AmericanRedCross/mapping-mozzie/docs/partslist.md

# Parts List
These are the purchased items that become part of the aircraft.  

| type | name | source | qty | US$ (ea) | gms (ea) |
|--|--|--|--:|--:|--:|
| [airframe](parts/airframe.md) | X-uav Mini Talon (non-PNP) | [Banggood](https://www.banggood.com/X-uav-Mini-Talon-EPO-1300mm-Wingspan-V-tail-FPV-Plane-Aircraft-Kit-p-983331.html) | 1 | 104 | 562 |
| [servos](parts/servos.md) | Corona DS-929MG Digital Servo 2.2kg / 0.11sec / 12.5g | [HobbyKing](https://hobbyking.com/en_us/corona-digital-servo-2-2kg-0-11sec-12-5g.html) | 4 | 7 | 13 |
| [airspeed sensor](parts/airspeed.md) | Holybro digital air speed sensor | [amazon](https://www.amazon.com/HolyBro-Air-Speed-Sensor/dp/B07FN6615W) | 1 | 67 | - |
| [flight controller (bundle)](parts/flightcontroller.md) | Pixhawk 4 and GPS and PM02 Bundle. SKU20068 | [Holybro](https://shop.holybro.com/pixhawk-4_p1089.html) | 1 | 196 | - |
| [computer (on-board companion)](parts/computer.md) | Raspberry Pi 4 Model B 2GB RAM | [Adafruit](https://www.adafruit.com/product/4292) | 1 | 35 | 45 |
| [computer micro SD card](parts/sdcard.md) | Samsung PRO Endurance 128GB 100MB/s (U1) MicroSDXC Memory Card (MB-MJ128GA/AM) | [Amazon](https://www.amazon.com/Samsung-Endurance-32GB-Micro-Adapter/dp/B07B984HJ5) | 1 | 20 | 1 |
| [USB connectors](parts/usb.md) |  |  |  |  |  |
| [camera](parts/camera.md) | Raspberry Pi High Quality HQ Camera - 12MP | [Adafruit](https://www.adafruit.com/product/4561) | 1 | 50 | - |
| [camera lens](parts/camera.md) | 6mm 3MP Wide Angle Lens for Raspberry Pi HQ Camera - 3MP | [Adafruit](https://www.adafruit.com/product/4563) | 1 | 25 | 53 |
| [camera mount wood](parts/camerawood.md) | Used to build camera mount. .11" or 3mm thick. See [link](parts/camerawood.md) for alternatives. | [Michaels](https://www.michaels.com/revell-birch-plywood-sheet-3mmx6inx12in/10307259.html) | 1 | 2 | - |
| [camera mount dampers](parts/cameradampers.md) | Used to isolate vibrations | [Amazon](https://www.amazon.com/gp/product/B07WGPVZM6/) | 1 | 8 | 12 |
| [receiver](parts/receiver.md) | FrSKy R-XSR | [getFPV](https://www.getfpv.com/frsky-r-xsr-2-4ghz-16ch-accst-micro-receiver-w-s-bus-cppm.html) | 1 | 21 | 2 |
| [radio modem](parts/radio.md) | RFD900x-US Telemetry Bundle (FCC approved) 2 modems + antennas + cables | [IR-LOCK](https://irlock.com/collections/rfdesign/products/rfd900-telemetry-bundle) | 1 | 219 | - |
| [radio antenna](parts/radioantenna.md) | RFDFLEX1 Antenna for use with RFD900x | [RFDesign](http://store.rfdesign.com.au/rfdflex1-900mhz-flexible-pcb-antenna-300mm-rpsma/) | 2 | 14 | 7 |
| [battery](parts/battery.md)** | Battery Turnigy LiPo 4S 10Ah 12C XT-90 JST-XH (14.8V, 148 Wh) | [HobbyKing](https://hobbyking.com/en_us/turnigy-high-capacity-10000mah-4s-12c-multi-rotor-lipo-pack-w-xt90.html) | 1 | 90 | 902 |
| [battery velcro straps](parts/battery.md) | For battery attachment to fuselage | [Amazon](https://www.amazon.com/gp/product/B08MZYWQ3L/) | - | 13 | - |
| [XT connectors](parts/xt.md) | for power loom. XT30, XT60, and XT90 male to XT60 female.  | [hobbyking](https://www.hobbyking.com) (details [here](parts/xt.md)) | - | 13 | - |
| [wire](parts/wire.md) | for power loom. 12, 14, 18 and 20AWG, red & black. | [hobbyking](https://www.hobbyking.com) (details [here](parts/wire.md)) | - | 12 | - |
| [Battery Eliminator Circuit](parts/bec.md) | Turnigy 5A (8-26v) SBEC for Lipo | [HobbyKing](https://hobbyking.com/en_us/turnigy-5a-8-26v-sbec-for-lipo.html) | 2 | 6 | 18 |
| [quad arm material](parts/quadarm.md) | Carbon fiber pultruded strip (1000mm x 20mm x 4mm) | [Carbon Kevlar Supply](https://carbonkevlarsupply.com/products/1-4mm-x-20mm-1000mm-pultruded-flat-carbon-fiber-bar-100-pultruded-high-strength-carbon-fiber-used-for-drones-radio-controlled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) | 1 | 14 | 221 |
| [quad ESC](parts/quadesc.md) | Electronic Speed Controller 30A | [rotorgeeks](https://rotorgeeks.com/spedix-es30-hv-esc) | 4 | 13 | 8 |
| [quad motor](parts/quadmotor.md) | Cobra CP 2207/2300. CP2207 2300KV 2450KV Brushless Motor | [Banggood](https://www.banggood.com/Cobra-Champion-Series-2207-CP2207-2300KV-2450KV3-5S-Brushless-Motor-For-250-260-280-FPV-Racing-Frame-p-1108143.html?ID=523221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) | 4 | 19 | 31 |
| [quad prop](parts/quadprop.md) | HQ 6x3.5, pack of 4 (2 reverse and 2 standard) | [Rotorgeeks](http://rotorgeeks.com/index.php?route=product/product&manufacturer_id=11&product_id=325) | 1 | 4 | - |
| [plane ESC](parts/planeesc.md) | ZTW 40A Brushless ESC with BEC 3A/5V Speed Controller with brake, with connector | [Amazon](https://www.amazon.com/ZTW-Brushless-Controller-Helicopter-Connector/dp/B07QNMQ5C3/) | 1 | 21 | 36 |
| [plane motor](parts/planemotor.md) | Cobra C-2814/16 KV=1050 | [Cobra](https://www.cobramotorsusa.com/motors-2814-16.html) | 1 | 32 | 109 |
| [plane prop](parts/planeprop.md) | Aero-naut 10x8 (inches) CAM Carbon Folding Blades | [Aloft Hobbies](https://alofthobbies.com/aeronaut-cam-10-x8-25-5x20-cm.html) | 1 | 12 | - |
| [plane prop holder](parts/planeprop.md) | Aero-naut 724222 (7242/22) | [Atlanta Hobby](https://www.atlantahobby.com/store/pc/42mm-Middlepart-Yoke-for-40mm-267p862.htm) | 1 | 10 | - |
| [plane prop bushing](parts/planeprop.md) | Aluminum, 8mm long, 8mm OD, 6mmID | [getFPV](https://www.getfpv.com/graupner-prop-reducer-8mm-to-6mm-4pcs.html) | 1 | 1 | 4 |
| [plane prop stop](parts/planeprop.md) | thin aluminum or old credit card piece | - | - | - | - |
| [servo lead extensions](parts/servoext.md) | For servos and for quad ESCs, bag of 5 | [HobbyKing](https://hobbyking.com/en_us/300mm-servo-lead-extension-jr-with-hook-26awg-5pcs-bag.html) | 2 | 3 | - |
| [brackets](parts/brackets.md) | Two for flight controller, one for pitot tube | [servocity](https://www.servocity.com) (details [here](parts/brackets.md)) | - | 6 | 33 |
| [bolts, nuts, spacers](parts/screwsetc.md) | - | - | - | - | - |
| [tape](parts/tapeetc.md) | for attaching items to airframe | [Office Depot](https://www.officedepot.com/a/products/717151/Scotch-Extreme-Shipping-Tape-With-Dispenser/) | 1 | 12 | - |
| [glue](parts/tapeetc.md) | Gorilla Clear Grip Contact Adhesive, Clear | [Amazon](https://www.amazon.com/Gorilla-Clear-Contact-Adhesive-Waterproof/dp/B06WGSRM4Z) | 1 | 8 | - |
| [velcro tape](parts/tapeetc.md) | for attaching items inside fuselage | [Amazon](https://www.amazon.com/VELCRO-Brand-Industrial-Fasteners-Professional/dp/B00006IC2U/) | 1 | 6 | - |
| [heat shrink](parts/tapeetc.md) | for wired connections and for quadarms | - | - | - | - |
| [solder](parts/tapeetc.md) | - | - | - | - | - |
| [thread locker](parts/tapeetc.md) | - | - | - | - | - |

See also: [Tools, supplies, and other ground items](toolsetc.md).

See also: [3D print list](parts/3dprints.md) (3D printing is optional).

**see important transport and safety information on the [safety page](safety.md)

Weights, dimensions and specs have not been double-checked.

Prices do not include shipping & tax.
