AmericanRedCross/mapping-mozzie/docs/parts/flightcontroller.md

# Flight Controller #

The bundle **includes all of** the following:

* Pixhawk 4 (plastic case) Pixhawk details: : [Holybro](https://shop.holybro.com/pixhawk-4_p1089.html)
* [GPS (UBLOX NEO-M8N)](https://shop.holybro.com/pixhawk-4-gps-module_p1094.html) or [bought separately](https://www.getfpv.com/holybro-pixhawk-4-neo-m8n-gps.html)
* [Power Module PM02](http://www.holybro.com/product/power-modulepm02-v3/), or [bought separately](https://shop.holybro.com/power-modulepm02-v3_p1185.html). Used to power the plane motor and converts battery voltage to 5.2V (3A max) to power the Pixhawk4, while reporting battery voltage for monitoring. This connection uses a 6-pos GH cable (included in the bundle).
* EXT-8P-V1.0 connectors. These two connectors and associated cables facilitate connecting the Pixhawk to the servos, quad ESCs, and plane ESC.
* various other cables (incl USB), connectors and hardware.
* foam mounting tape
* Micro SD Card: 8GB (HC high capacity) Class 4. "SD cards are most commonly used to log and analyse flight details... The SanDisk Extreme U3 32GB is highly recommended" per [px4 documentation](https://docs.px4.io/v1.9.0/en/assembly/quick_start_pixhawk4.html).

All of the above are included in the bundle, Item Code 20068 (SKU20068).
