AmericanRedCross/mapping-mozzie/docs/parts/quadesc.md

## Quad ESCs

Qty 4

Purchased from [Rotor Geeks](https://rotorgeeks.com/spedix-es30-hv-esc), and also available direct from [www.spedix-rc.com](http://www.spedix-rc.com/index.php/esc/blheli-s/d68bf2da363e9b8fdb776b698a10fc28.html). They required soldering to the pads on the ESC. That might be simpler, no heat shrink on the individual wires, but less forgiving.

The [ESC on the original mozzie](https://hobbyking.com/en_us/spider-pro-premium-30a-opto-2-6s.html) already had three wires attached. Those wires just needed to be soldered to the motor wires, and each of those connections were heatshrinked.

[alternative 1](https://hobbyking.com/en_us/flycolor-x-cross-bl-32-35a-brushless-esc.html)

[alternative 2](https://www.getfpv.com/lumenier-30a-blheli-s-esc-opto-2-4s.html)

The quad ESCs don't need BEC. Without BEC they are quieter, smaller and lighter.
