AmericanRedCross/mapping-mozzie/docs/parts/xt.md

## XT Connectors

* [XT30 Connector pairs](https://hobbyking.com/en_us/xt30u-m-f-male-female-5pairs-per-bag.html) 2 bags of 5 pairs, $5 total.
* [XT60 Connector pairs](https://hobbyking.com/en_us/genuine-xt60-nylon-connectors-male-female-5-pairs.html) 1 bag of 5 pairs, $4.
* [XT90 male to XT60 female](https://hobbyking.com/en_us/xt90-male-to-xt60-female-2pcs-bag.html) $4. This is used if the battery has an XT90 connector: to connect to power loom, for servo setup, and for charging (depending on your battery charger).
* See also: notes about [parallel connector](battery.md)

For the XT connectors, "male" and "female" refer to the metal-to-metal contact, not the plastic-plastic contact. They also might be labeled "M" of "F".
