AmericanRedCross/mapping-mozzie/docs/parts/screwsetc.md

## Screws, nuts, spacers
This page only lists extra hardware to purchase; it does not list hardware included with other purchases.  
Ideally everything on this list should be metric, but the initial build was done with hardware that was on-hand.

### Screws
| thread | length | qty | descr | nuts* | spacer length** | task(s) |
|--|--|--|--|--|--|--|
| 6-32 | [0.375"](https://www.servocity.com/6-32-x-0-375-3-8-zinc-plated-socket-head-machine-screw/) | 4 | Zinc-Plated Socket Head Machine Screw | yes | -- | [frame brackets](../tasks/frame_brackets.md) |
| 6-32 | [1.25"](https://www.servocity.com/6-32-x-1-25-1-1-4-zinc-plated-socket-head-machine-screw/) | 4 | Zinc-Plated Socket Head Machine Screw | yes | 0.375" | [Airframe Close](../tasks/airframe_close.md) front |
| 6-32 | [1.5"](https://www.servocity.com/6-32-x-1-50-1-1-2-zinc-plated-socket-head-machine-screw/) | 4 | Zinc-Plated Socket Head Machine Screw | yes | 1" | [Airframe Close](../tasks/airframe_close.md) rear |
| 6-32 | [0.875"](https://www.servocity.com/6-32-x-0-875-7-8-zinc-plated-socket-head-machine-screw/) | 4 | Zinc-Plated Socket Head Machine Screw | yes | 0.375" | [Airframe Close](../tasks/airframe_close.md) camera |
| 2-56 | [0.75"](https://www.homedepot.com/p/Everbilt-2-56-x-3-4-in-Phillips-Flat-Head-Zinc-Plated-Machine-Screw-8-Pack-803581/204791282) | 4 | Zinc Plated Phillips Flat Head Machine Screw | yes | -- | [camera assemble](../tasks/camera_assemble.md) |
| M3 | [8mm](https://www.pololu.com/product/1076) | 20 | Zinc Plated Phillips Pan Head Machine Screw | just 4 | -- | [quadarm assemble](../tasks/quadarm_assemble.md), [plane motor mount](../tasks/planemotor_mount.md) |
|  |  |  |  |  |  |  |

### *Nuts
| thread | descr | qty |
|--|--|--|
| [6-32](https://www.servocity.com/6-32-nylock-nuts-pack-25-pack/) | nyloc nylon insert | 16 |
| [2-56 Nylock](https://www.boltdepot.com/Product-Details.aspx?product=20577) | nyloc nylon insert | 4 |
| [M3](https://www.boltdepot.com/Product-Details.aspx?product=4370) | nyloc nylon insert | 4 |
|  |  |  |

### **Spacers
| length | O.D. | I.D. | qty |  |
|--|--|--|--|--|
| [0.375"](https://www.servocity.com/0-375-6-round-nylon-spacer-0-140-i-d-0-250-o-d/) | 0.25" | 0.14"  | 8 | [alternative](https://www.servocity.com/0-375-length-1-4-od-aluminum-spacers-for-6-screw-size-0-140-id/) |
| [1.0"](https://www.servocity.com/1-00-6-round-nylon-spacers-0-140-i-d-0-250-o-d/) | 0.25" | 0.14"  | 4 | [alternative](https://www.servocity.com/1-000-length-1-4-od-aluminum-spacers-for-6-screw-size-0-140-id/) |  
|  |  |  |  |  |

more nylon spacers are [available here](https://www.pololu.com/category/93/spacers).

Spacers allow tightening the screws without crushing the fuselage. Also, being larger in diameter than the screws, they distribute the lateral and rotational forces better than the screws alone. Here are rough thicknesses for the fuselage in various locations:

* 10mm or .4" at the front quadarm
* 27mm or 1.1" at the read quadarm
* 10mm or .4" at the camera mount
