AmericanRedCross/mapping-mozzie/docs/parts/airframe.md

# Air Frame #
*Description:* X-UAV Mini Talon. EPO 1300mm Wingspan V-tail Plane Aircraft Kit. This is the non-PNP (non-plug-and-play) version. Other items, like servos motor and ESC are bought separately. Length 830mm.

*Source(s):*
[Banggood](https://www.banggood.com/X-uav-Mini-Talon-EPO-1300mm-Wingspan-V-tail-FPV-Plane-Aircraft-Kit-p-983331.html) and others.

Weights:  
wood pieces 72g  
spars 102g  
servo hardware, pusher rods, screws, etc 14g  
wheel etc 8g  
wings and tail 244g  
fuselage 124g  
--------------------------
564g
