AmericanRedCross/mapping-mozzie/docs/parts/airspeed.md

# Airspeed Sensor #
**Description:** Pixhawk digital differential airspeed sensor with Measurement Specialties 4525DO sensor. Supported on all Pixhawk and PX4 autopilot generation boards. Includes sensor, 4pin cable, rubber tubing, and pitot tube.

**Source(s):**
[amazon](https://www.amazon.com/HolyBro-Air-Speed-Sensor/dp/B07FN6615W) and others.
