AmericanRedCross/mapping-mozzie/docs/parts/camera.md

## Camera

[Raspberry Pi High Quality Camera](https://www.raspberrypi.org/products/raspberry-pi-high-quality-camera/), purchased from [Adafruit](https://www.adafruit.com/product/4561)

12.3 megapixels, 7.9 mm sensor diagonal, 1.55 μm × 1.55 μm pixel size, Back focus Adj (12.5 mm–22.4 mm), Integrated IR cut filter

Camera includes cable to connect to Raspberry Pi.

Does not include lens.

## Lens
Purchased from [Adafruit](https://www.adafruit.com/product/4563)

φ30×34

Image format 1/2", Focal length: 6mm, Aperture: F1.2, Mount: CS, Field Angle (D×H×V(°): 63°.

not sure of reqd lens specs.

alternate source Canakit.
