AmericanRedCross/mapping-mozzie/docs/parts/cameradampers.md

## Camera dampers

Purchased from [Amazon](https://www.amazon.com/gp/product/B07WGPVZM6/). Qty is 12 for $8 but only need qty 4.

3 gm each, 12 gm total.

Alternatives will require different fabrication dimensions for camera plates and hardware:

* [alt 1](https://hobbyking.com/en_us/vibration-damping-ball-50gram-8-pcs-bag.html) used in Mozzie,
* [alt 2](https://www.amazon.com/gp/product/B07VPVR4V7/).
