AmericanRedCross/mapping-mozzie/docs/parts/planemotor.md

## Plane Motor

Cobra C-2814/16 Brushless Motor, Kv=1050

[Cobra Motor USA](https://www.cobramotorsusa.com/motors-2814-16.html)

Alt source (same motor): [Innov8tive Designs](https://innov8tivedesigns.com/cobra-c-2814-16-brushless-motor-kv-1050.html)
