AmericanRedCross/mapping-mozzie/docs/parts/planeprop.md

this page is for the prop AND the prop holder.

## Plane prop
Aero-naut 10x8 (inches) CAM Carbon Folding Blades (25.5x20 cm)  
[Aloft Hobbies](https://alofthobbies.com/aeronaut-cam-10-x8-25-5x20-cm.html)

[alt source 1](https://www.hacker-motor-shop.com/Air-screws-and-accessories/Folding-propellers/aero-naut/Aeronaut-CAM-Carbon-10X8.htm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)
10718200 EAN: 4012230077512

[alt source 2](https://www.gravesrc.com/aeronaut-cam-folding-propeller-10-x-8.html)
AERONAUT7234/32

"Aero-naut CAMcarbon 10"x8" folding propeller blades, with profile developed by Rudi Freudenthaler. High performance, efficient propeller blades with 8mm root for 3mm fixing screw. All Aeronaut CAMcarbon folding propeller blades have 8mm blade roots."

## Prop holder
Also known as spinner bar, center hub, yoke,

Aero-naut 724222 (7242/22)

42mm Middlepart Yoke for 40mm, folding prop bar.

alt sources: [alt_1](https://www.perthrc.com.au/spinner-bar-42mm-0-degrees.html?sef_rewrite=1), [alt_2](https://www.hoelleinshop.com/All-you-need-for-electric-flight/Props-and-adapters/Center-hub-for-folding-props/Aeronaut-center-hubs/Aluminium-center-hub-42mm-0-724222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), [alt_3](https://www.hobbyclub.com/index.php?main_page=product_info&cPath=&products_id=1257), [alt_4](https://www.dodax.com/en-us/toys-baby/rc-vehicles/aeronaut-aero-naut-724222-radio-controlled-rc-model-part-dpS5BB2CNKK57/)

## Prop reducer/spacer/bushing
This 8mm to 6mm Reducer fits between the motor shaft and prop holder. Approx 8mm long.

[Source1](https://www.getfpv.com/graupner-prop-reducer-8mm-to-6mm-4pcs.html) "for Graupner Props"

[Source2](https://www.aluminumspacers.com/mas8-6-8)

## Prop blade stop
You can use an old credit card or thin plywood or ~1mm thick aluminum plate for making blade stops. [More info](../tasks/planemotor_mount.md)
