AmericanRedCross/mapping-mozzie/docs/parts/quadarm.md

# Quad Arm Material #
**Description:** 4mm x 20mm 1000mm - PULTRUDED-Flat Carbon Fiber Bar or Strip.

**Source(s):**
[Carbon Kevlar Supply](https://carbonkevlarsupply.com/products/1-4mm-x-20mm-1000mm-pultruded-flat-carbon-fiber-bar-100-pultruded-high-strength-carbon-fiber-used-for-drones-radio-controlled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)  

Alternate source: Dragonplate

The 1000mm piece will be cut into two 400mm lengths for quad arms and two 70mm lengths which are used as backing plates when bolting the arms to the fuselage. [details](../tasks/quadarm_prep.md)  

If available, it's probably OK to use a thinner 3mm strip.  

The [Mozzie](https://mozzie.readthedocs.io/en/latest/) used a smaller pultruded carbon fiber strip (3mm x 15mm), plus 3d prints for attaching mounts, plus 3d prints to attach the arms to the fuselage.
