AmericanRedCross/mapping-mozzie/docs/parts/quadmotor.md

## Quad Motors

Qty 4

Cobra CP 2207/2300. CP2207 2300KV 2450KV Brushless Motor
