AmericanRedCross/mapping-mozzie/docs/parts/radioantenna.md

## Radio antenna

These antennas are stucked onto the tail pieces. Qty 2. Markings:  

* RFDANT 900 FLEX1  
* 902 928 MHz ISM BAND antenna
* rfdesign.com.au

[source 1 - rfdesign](http://store.rfdesign.com.au/rfdflex1-900mhz-flexible-pcb-antenna-300mm-rpsma/)

[soure 2 - silvertone electronics](https://silvertoneelectronics.com/product/rfdflex1-900mhz-flexible-pcb-antenna-300mm-rpsma/)

[source 3 - nextfpv](https://www.nextfpv.com/products/rfdflex1-900mhz-flexible-pcb-antenna-500mm-rpsma?currency=USD)

[bought from HeliBatics but no longer available](https://www.helibatics.com/rfdflex1-900mhz-flexible-pcb-antenna-200mm-rpsma/)
