AmericanRedCross/mapping-mozzie/docs/parts/receiver.md

## Receiver

The receiver is bound to a transmitter which can control the drone. (Alternatively the drone can be controlled with a laptop via radio modem). 16x11x5.4 mm.

[Source 1 - Banggood](https://www.banggood.com/X-uav-Mini-Talon-EPO-1300mm-Wingspan-V-tail-FPV-Plane-Aircraft-Kit-p-983331.html)

[Source 2 - getFPV](https://www.getfpv.com/frsky-r-xsr-2-4ghz-16ch-accst-micro-receiver-w-s-bus-cppm.html)

[Reviewed by Oscar Liang](https://oscarliang.com/frsky-r-xsr-receiver/)
