AmericanRedCross/mapping-mozzie/docs/parts/tapeetc.md

## Tape
[This "Scotch® Extreme Shipping Tape" is what was on-hand](https://www.officedepot.com/a/products/717151/Scotch-Extreme-Shipping-Tape-With-Dispenser/). Twenty-one yards is overkill, you won't need much. Other tapes will probably work fine. This tape is used to attach items to the inside of the fuselage and to cover items on the wings, including:

* airspeed sensor tubing,
* receiver antennas,
* servos (cover on wing),
* GPS (cover on wing)

## Glue
["Gorilla Clear Grip Contact Adhesive" was used on the initial build](https://www.amazon.com/Gorilla-Clear-Contact-Adhesive-Waterproof/dp/B06WGSRM4Z). It is [recommended here](https://www.itsqv.com/QVM/index.php?title=X-UAV_Mini_Talon_Build_Compilation#First_-_It.27s_all_about_Glue). This amount is overkill. Other glues will work fine. The original Mozzie used UHU Por glue. Glued items include:

* internal wooden frame,
* spacers,
* airspeed pitot tube to bracket,
* airspeed pitot tube tip,
* airframe pieces: wings, tail, fuselage halves, motor mount, carbon rods, servos, servo control horns.

## Velcro Tape
[VELCRO Brand - Industrial Strength | Indoor & Outdoor Use | Superior Holding Power on Smooth Surfaces](https://www.amazon.com/VELCRO-Brand-Industrial-Fasteners-Professional/dp/B00006IC2U/). Others will probably work fine. Velcro tape is used to attach items to the  airframe (mainly the inside of the fuselage), including:

* the air speed sensor (just the board)
* the receiver (just the board)
* the radio modem RFD900
* the plane ESC
* Battery(s) along with velcro straps
* GPS (to wing) (?)
* Raspberry Pi (to camera)

Velcro tape can also be used along the inside of the fuselage to create wiring harnesses.

See also: [Velcro straps for battery(s)](battery.md)

## Heat Shrink
Color is not that important. Lengths are approximate -- have extra on-hand.

| Dia | Length | color | for |
|---|---|---|---|
| 3/4" | 23" | black | [quadarm assemble](../tasks/quadarm_assemble.md) |
| 3/8" | 40mm | red | [power loom nodes](../tasks/nodes.md) |
| 3/8" | 40mm | black | [power loom nodes](../tasks/nodes.md) |
| 1/4" | 40mm | red | [power loom nodes](../tasks/nodes.md) |
| 1/4" | 40mm | black | [power loom nodes](../tasks/nodes.md) |
| 3/16" | 150mm | red | [power loom nodes](../tasks/nodes.md), [XT to wires](../tasks/xtwires.md) |
| 3/16" | 150mm | black | [power loom nodes](../tasks/nodes.md), [XT to wires](../tasks/xtwires.md) |
| 3/32" | 180mm | red | [XT to parts](../tasks/xtparts.md), [XT to wires](../tasks/xtwires.md) |
| 3/32" | 180mm | black | [XT to parts](../tasks/xtparts.md), [XT to wires](../tasks/xtwires.md) |

Used 3:1 shrink ratio with adhesive.

[3/4" dia from Amazon](https://www.amazon.com/gp/product/B07FP6ZT8Q/) $7

[smaller sizes from Amazon](https://www.amazon.com/gp/product/B00NPBUWRC/) $15

## Solder
[Leaded rosin flux core from Amazon](https://www.amazon.com/gp/product/B000G36BYU/) $11

## Thread locker
Used [Loctite 487229 Threadlocker 242 All-Purpose Medium Strength](https://www.amazon.com/gp/product/B000FIXQXK/) $9

Avoid contacting plastic with thread locker.
