AmericanRedCross/mapping-mozzie/docs/parts/usb.md

## USB cable

The Pixhawk 4 comes with a USB-A to USB-micro cable that can be used to connect the Pixhawk to the Raspberry Pi. However, space is tight in the fuselage, so this items will help:

* [Short Micro USB Cable - Type A Male to Micro Type B Male](https://www.amazon.com/gp/product/B003YKX6W2/), $6, 14gm

The left angle on the micro-USB end makes it easier to fit.
