AmericanRedCross/mapping-mozzie/docs/parts/wire.md

## Wire

* [Wire 12AWG 330mm 1xBlack](https://hobbyking.com/en_us/turnigy-high-quality-12awg-silicone-wire-1m-black.html) $2
* [Wire 12AWG 330mm 1xRed](https://hobbyking.com/en_us/turnigy-high-quality-12awg-silicone-wire-1m-red.html) $2
* [Wire 14AWG 530mm 1xBlack](https://hobbyking.com/en_us/turnigy-high-quality-14awg-silicone-wire-1m-black.html) $2
* [Wire 14AWG 530mm 1xRed](https://hobbyking.com/en_us/turnigy-high-quality-14awg-silicone-wire-1m-red.html) $2
* [Wire 18AWG 160mm 1xBlack](https://hobbyking.com/en_us/turnigy-high-quality-18awg-silicone-wire-1m-black.html) $1
* [Wire 18AWG 160mm 1xRed](https://hobbyking.com/en_us/turnigy-high-quality-18awg-silicone-wire-1m-red.html) $1
* [Wire 20AWG 36mm 1xBlack](https://hobbyking.com/en_us/turnigy-high-quality-20awg-silicone-wire-2m-black.html) $1
* [Wire 20AWG 360mm 1xRed](https://hobbyking.com/en_us/turnigy-high-quality-20awg-silicone-wire-2m-red.html) $1
* [alternatives](https://www.amazon.com/gp/product/B0746H2K6G/)
