AmericanRedCross/mapping-mozzie/3d/camera_plate_top.stl

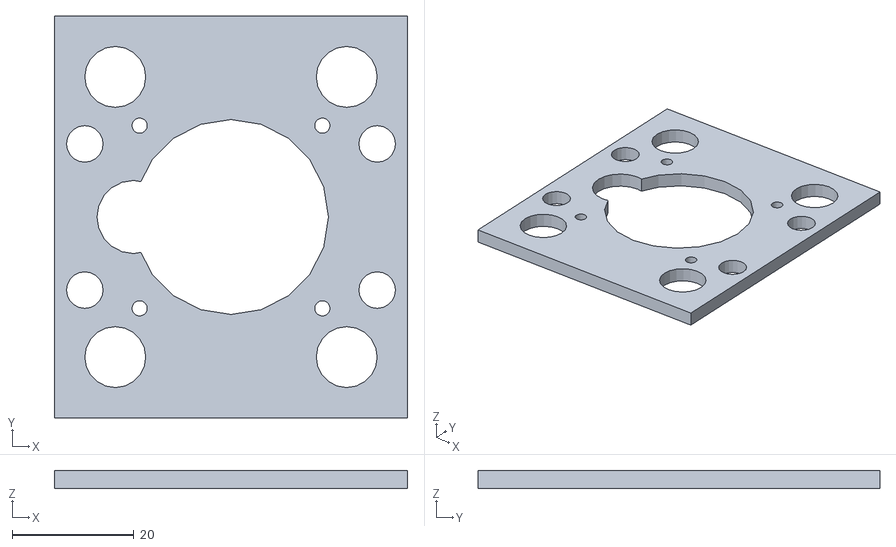
[picture p33: CAD file, 2021-07-02]
3d/camera_plate_top.stl
58.0 x 66.0 x 3.00
