AmericanRedCross/mapping-mozzie/3d/camera_plate_mid.stl

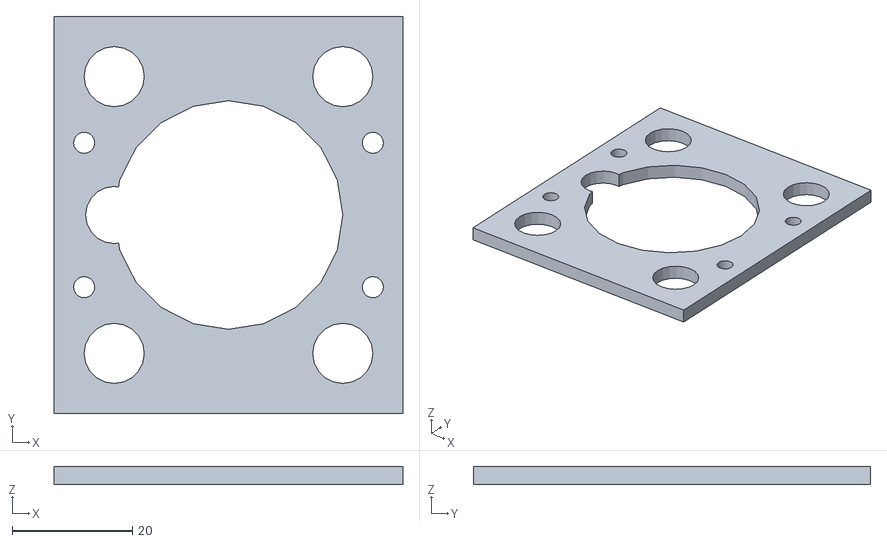
[picture p34: CAD file, 2021-07-02]
3d/camera_plate_mid.stl
58.0 x 66.0 x 3.00
