AmericanRedCross/mapping-mozzie/3d/bracket_small.stl

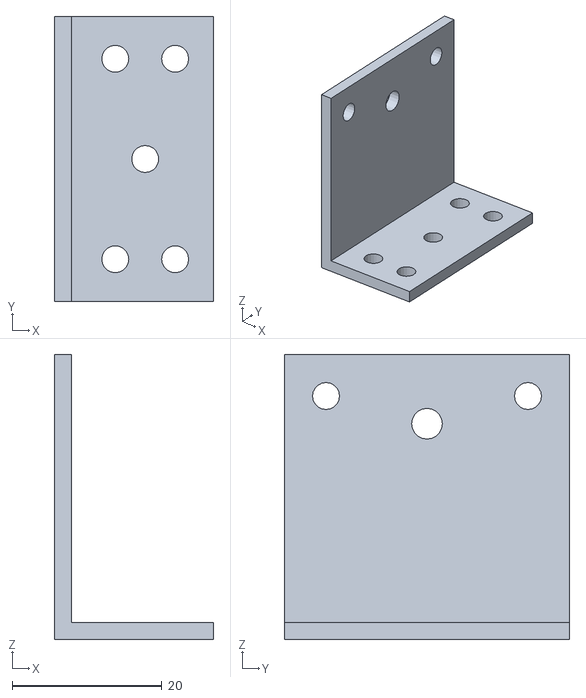
[picture p35: CAD file, 2021-07-02]
3d/bracket_small.stl
21.3 x 38.1 x 38.1
