AmericanRedCross/mapping-mozzie/3d/motor_hole_template.stl

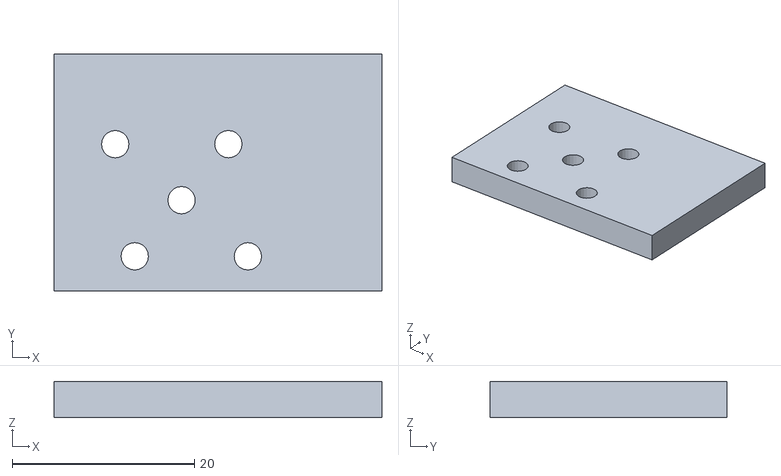
[picture p36: CAD file, 2021-07-02]
3d/motor_hole_template.stl
36.0 x 26.0 x 4.00
