AmericanRedCross/mapping-mozzie/3d/camera_plate_bottom.stl

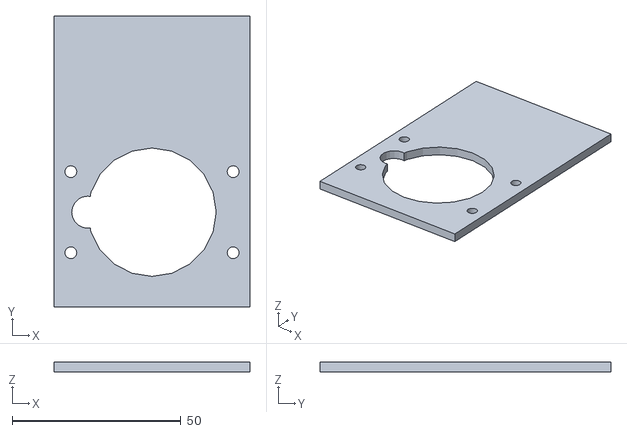
[picture p37: CAD file, 2021-07-02]
3d/camera_plate_bottom.stl
58.0 x 86.0 x 3.00
