AmericanRedCross/mapping-mozzie/3d/bracket_large.stl

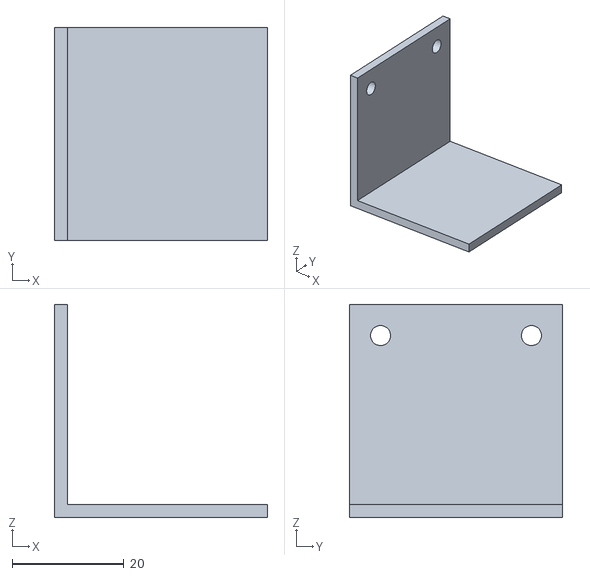
[picture p38: CAD file, 2021-07-02]
3d/bracket_large.stl
38.1 x 38.1 x 38.1
