AmericanRedCross/mapping-mozzie/docs/images/esc_motor_wirelength.jpg

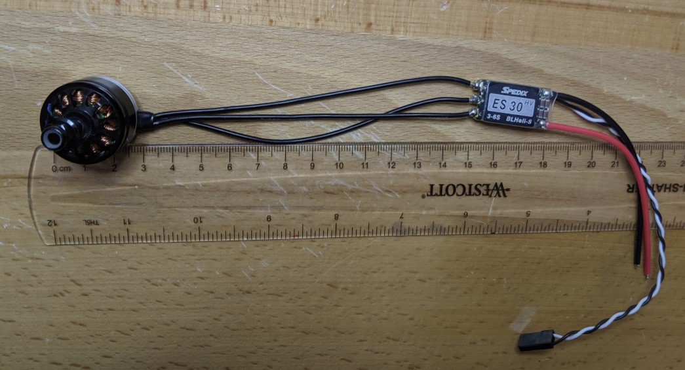
[picture p47: docs/images/esc_motor_wirelength.jpg]
