AmericanRedCross/mapping-mozzie/docs/tasks/finish_build.md

## Finish Build

Glue airframe  
velcro RPi to top of camera?  
The center of gravity, per the mini talon instructions, should be about 50mm behind the wing leading edge.  
connections  
wheel, skid, hatch
